charJe/power-user/readme.org

#+title: Power User Keyboard
#+author: Charles

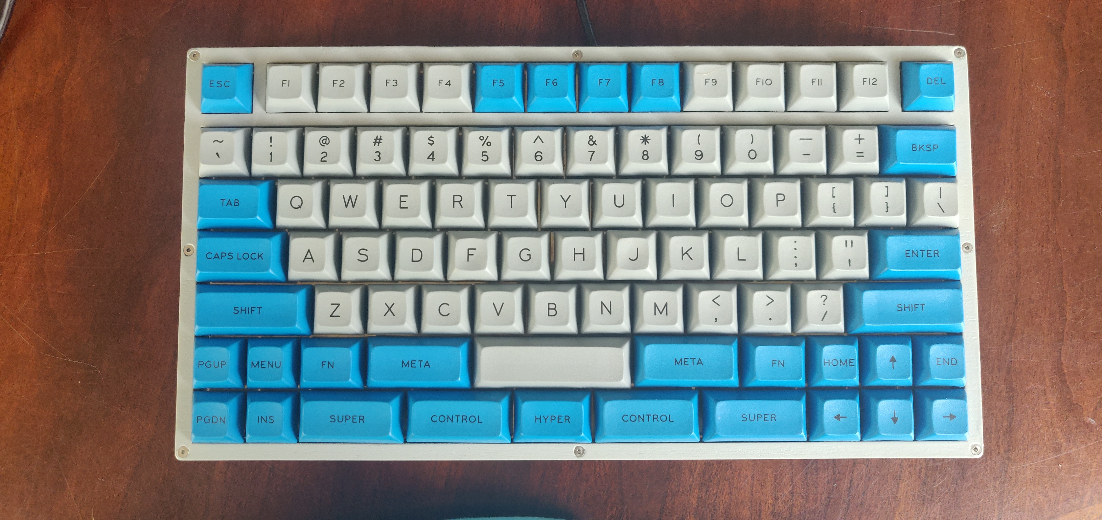
[picture p1: images/done.jpg]


This is a walk through of how I made this keyboard with a non-conventional (extra) bottom row. I hope that it can serve others trying to make custom keyboards.

* Parts and Cost
| Part             | Vendor               | Price ($) | Actual ($) |
|------------------+----------------------+-----------+------------|
| Switches (90)    | [[https://novelkeys.xyz/products/novelkeys-x-kailh-box-heavy-switches?variant=3747939942440][novelkeys.xyz]]        |     27.00 |      30.69 |
| Key caps (alpha) | [[https://pimpmykeyboard.com/dsa-standard-sublimated-keysets/][pimpmykeyboard.com]]   |     50.00 |      50.00 |
| Key caps (mods)  | [[https://pimpmykeyboard.com/dsa-standard-sublimated-keysets/][pimpmykeyboard.com]]   |     40.00 |      40.00 |
| Custom caps      | [[https://pimpmykeyboard.com/dsa-individual-keys/][pimpmykeyboard.com]]   |     42.00 |      42.00 |
| Space bar        | [[https://pimpmykeyboard.com/dsa-3-space/][pimpmykeyboard.com]]   |      5.00 |       5.00 |
| Case             | [[https://www.pololu.com/laserquote][pololu.com]]           |    142.00 |     156.95 |
| bolts            | [[https://www.ebay.com/itm/M2-M2-5-M3-M4-M5-M6-Hex-Socket-Countersunk-Flat-Head-Screws-Bolts-304SS-DIN7991-/173979134769][ebay.com]]             |     10.00 |      10.83 |
| nuts             | [[https://www.ebay.com/itm/Metric-Stainless-Steel-Hex-Nuts-DIN-934-M2-M2-5-M3-M3-5-M4-M5-M6-M8-M10-M12-M14-/112604642017][ebay.com]]             |      3.70 |       4.01 |
| Controller       | [[https://www.pjrc.com/store/teensy.html][pjrc.com]]             |     16.00 |      23.84 |
| Diodes (100)     | [[https://www.ebay.com/itm/100pcs-Brand-New-1N4148-switching-signal-DIODE-ST-DO-35-TZM-afe/113797539967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][ebay.com]]             |      1.35 |       1.93 |
| Stabilizers      | [[https://www.amazon.com/dp/B07K8FFDYJ/ref=psdc_12879431_t2_B07K8G6V1J?th=1][amazon.com]]           |      9.00 |       9.74 |
| USB cable        | [[https://www.amazon.com/gp/product/B000I1IGQ6/ref=ox_sc_act_title_1?smid=A2JSBUBRVPP4SX&psc=1][amazon.com]]           |      3.99 |       4.32 |
| Feet             | Lowes hardware store |      5.69 |       6.47 |
|------------------+----------------------+-----------+------------|
| Total            | -------------------  |    355.73 |     385.78 |
#+tblfm: @15$3=vsum(@2$3..@-1$3)::@15$4=vsum(@2$4..@-1$4)
So about $400 if you include tools and maybe paint.

*Switches* are the parts that complete the electrical circuits. They are the biggest dictator of the feel of your keyboard. For the most part, they come in clicky, tactile, or linear. Make sure they are plate mounted.
*Key caps* are the actual buttons that you touch with your fingers. They usually have letters (legends) on them and are pretty colors. Theses come in different [[https://flashquark.com/wp-content/uploads/2019/08/MDA-Profile-Comparison.jpg][profiles]].
*Case* is the skeleton of your keyboard. In this case it is like a sandwich: many layers that are screwed together. The *plate* is what the switches will fit into.
*Bolts* are finely threaded screws that will hold the case together.
*Nuts* are small hexagonal screw holes that the bolts will screw into to hold the keyboard together. 
*Controller* or micro-controller is a small computer that will take inputs from the switches and send the appropriate signal to your actual computer.
*Diode* is like a [[https://minecraft.gamepedia.com/Redstone_Repeater][redstone repeater]] in that it doesn't let electricity flow "backwards". It will make sure you're keyboard works the way you expect it by stopping the "ghosting" and "masking" problems.
*Stabilizers* keep the long keys on your keyboard from being unstable. Make sure they are plate mounted.
*USB cable* is a usb-b to usb-a wire to connect your micro-controller to your computer.

* Layout
Go crazy on [[http://www.keyboard-layout-editor.com][keyboard-layout-editor.com]], but keep in mind that colors and legends will be limited mainly by what key caps you can find. Know that you may have to adjust your design or pay extra when it comes to key caps. You can use color swatches (at the top of page) to get an idea of what colors are available from different companies.
Here was my final design:
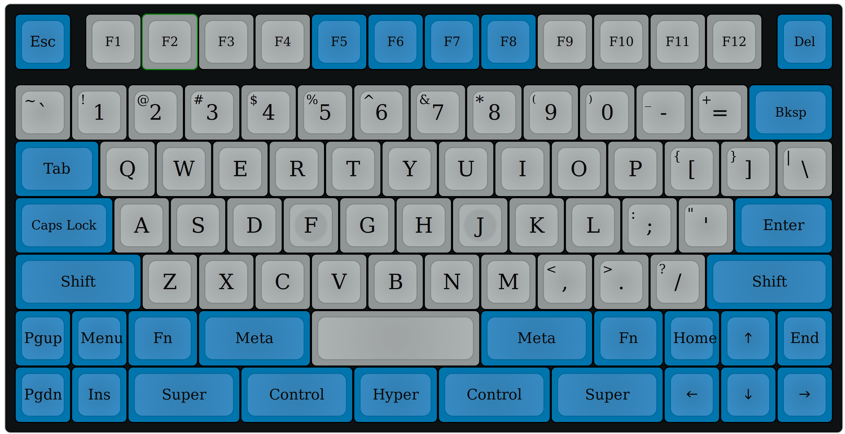
[picture p2: images/layout.png]

* Key caps
I decided Signature Plastics because they have the highest quality custom caps. 

I chose DSA profile because my keyboard has 7 rows, and the 7th row is unavailable on other profiles. DSA is also aesthetically pleasing. It is easier to change keyboard layouts with a non-sculpted profile such as DSA.

For the material, please use something better than ABS plastic; you want your keyboard to be nice for a very long times; the ones I'm getting are PBT plastic. Along the same lines get Dye-sublimated or Double-shot legends so your legends don't rub away (I've heard mixed opinions about laser engraved, and I don't really know).

First, the space bar. They have a 3 unit one in limited colors; I got grey (GDE). The alpha keys need to match the space bar, so I got TKL English Alpha kit (58 grey (GDE) keys). The modifiers can be whatever color; I got TLK text modifiers (33 blue (BCT) keys). I still need some custom ones to complete my abnormal bottom row and right column: 
- 1 unit:
  - "|\"
  - "Menu"
- 1.25 unit: 
  - "Fn" \times 2
- 1.5 unit:
  - "Hyper"
  - "Backspace"
- 1.75 unit:
  - "Enter"
- 2 unit:
  - "Meta" \times 2
  - "Super" \times 2
  - "Control" \times 2
- 2.25 unit:
  - "Shift"
These 14 keys will be blue (BCT) except "|\" which will be grey (GDE).
Here they are laid out on the table:
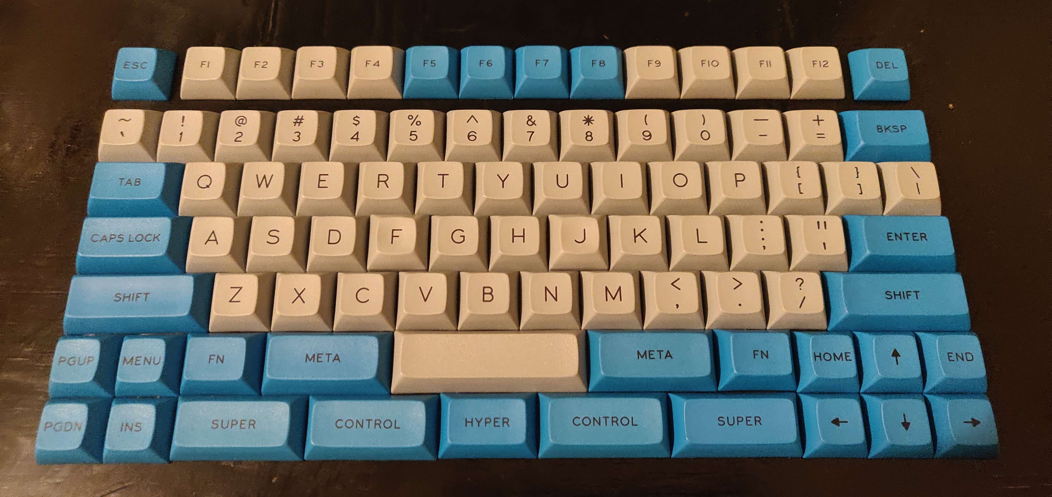
[picture p3: images/key-caps.jpg]


* Case
Copy the [[https://json.org][json.org]] data from the "</> Raw Data" section of [[http://www.keyboard-layout-editor.com][keyboard-layout-editor.com]] into [[http://www.builder.swillkb.com][builder.swillkb.com]] and use the following settings as a guide.
** SVG
If it's not here it is turned off.
| Switch        | MX              |
| Stabilizer    | Cherry + Costar |
| Case          | Sandwich        |
| USB cutout    | -10, 6          |
| Mount holes   | 8, 2.1, 6       |
| Edge padding  | 6, 6, 6, 6      |
| Plate corners | 2               | 
| Kerf          | .008            | 
| Line color    | blue            |

Kerf is important. .008 is for Pololu. If you're using a different laser cutting facility, make sure that you use whatever kerf they specify.

After inputting all the information, have them make the SVG files and download them.

** Laser cutting
| top, open      | 1/4in wood                    |
| bottom         | 0.03in stainless steel        |
| plate          | 0.06in stainless steel        |
| closed \times 2     | 1/8in wood                    |
|----------------+-------------------------------|
| Total -------- | 13/16in (20.5mm, 12.7 inside) |

I used Pololu for this part. Just upload the designs and select whatever materials you want. The plate should be a ridged material, and *the thickness should match your switches and stabilizers*. Make sure you have enough space inside the case to fit the micro controller about (mine just barely fit with .5in (12.7mm)). Space inside would be /open/ + /closed/ \times 2. I chose to use wood so I could countersink, sand, and paint it.

Before painting and countersinking
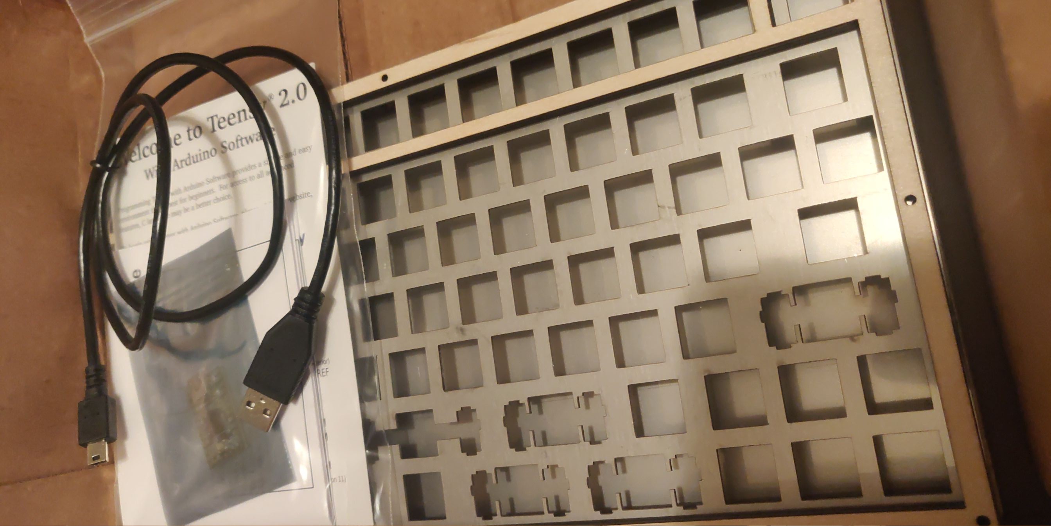
[picture p4: images/plate-teensy.jpg]


After painting and countersinking
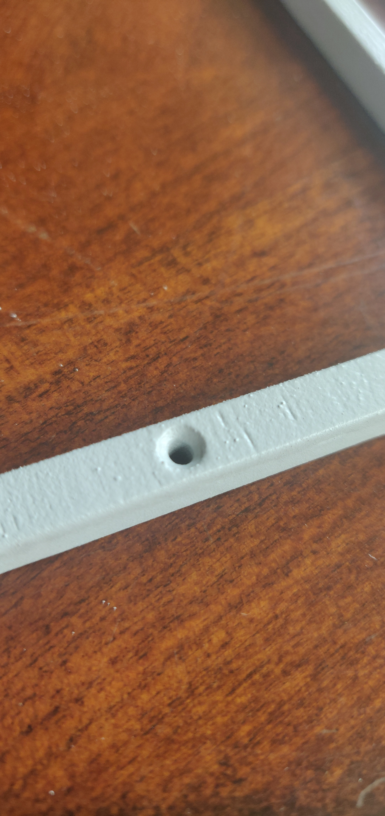
[picture p5: images/done-countersink-paint.jpg]

* Switches
I like clicky switches. With some research, I decided on Kailh pale blue BOX switches. I found a set of 90, so I'll have 3 extras. Since we are not using a PCB, make sure the switches are /plate mounted/, the stabilizers should also be /plate mounted/.
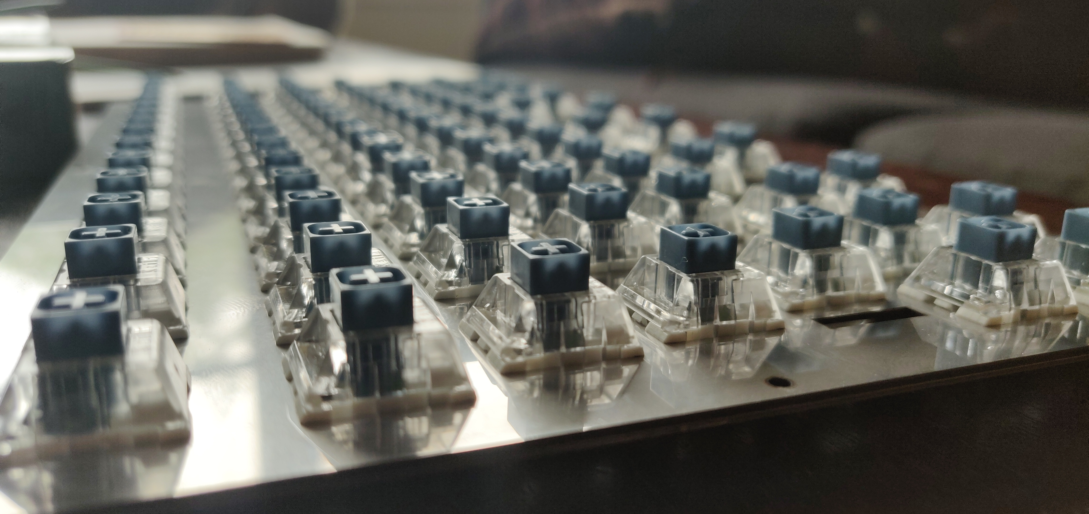
[picture p6: images/switches.jpg]

* Firmware
You should do this before assembly to make sure that everything fits together before soldering. Since I will be using Teensy 2, I'll need the following:
- Install [[https://www.arduino.cc/en/Main/Software][Arduino]] from their website, not your operating system package manage; the Teensy software only works with the version from their website.
- Download and follow instructions for installing [[https://www.pjrc.com/teensy/td_download.html][Teensyduino]].

Documentation:
Get key presses from switches: [[https://www.pjrc.com/teensy/td_digital.html][input documentation]]
Send key presses to computer: [[https://www.pjrc.com/teensy/td_keyboard.html][output documentation]]

For your firmware you should have a plan on how your rows and columns will connect to your micro-controller. This was my plan:

How to connect rows and columns to micro-controller
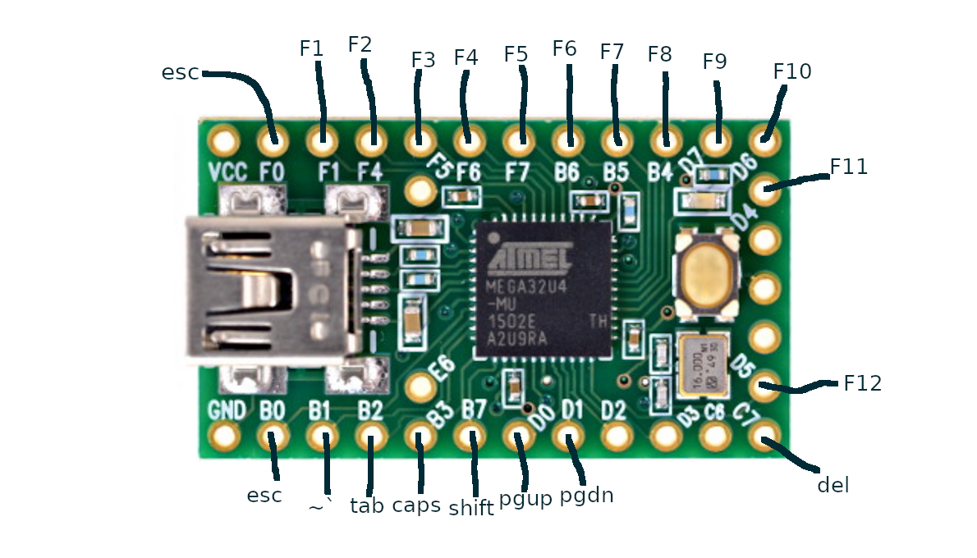
[picture p7: images/schema.png]


Which keys are on which row and column
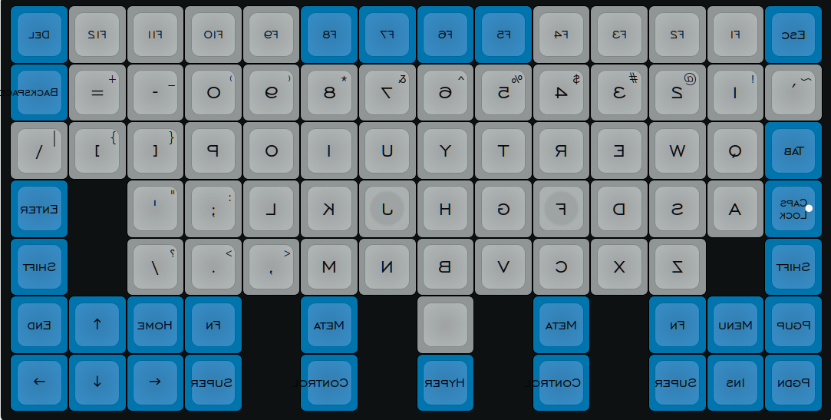
[picture p8: images/matrix.png]

This is reversed because when you are actually soldering, you're looking at the back of the keyboard.
* Assembly
Putting together the case, switches, and key caps should be obvious. The hard part is the wiring. You can look up how to solder by yourself. Remember: 
  - That the wires should be touching before you apply solder.
  - Solder flows to the hottest point, so don't remove the soldering iron until you see the solder flowing to the wires.
  - It's not the end of the world if you mess up; you have extra parts right?
  - The black stripe on the diode should point away from the switch contact it is soldered to.
Here is how the matrix works so you can be more confident.
http://pcbheaven.com/wikipages/How_Key_Matrices_Works/
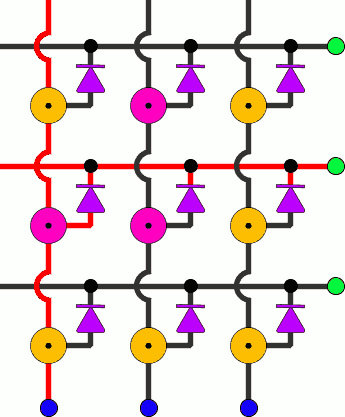
[picture p9: images/sample-matrix.gif]


This part of the guide will be mainly image and example based.
I would suggest preparing all the wires first before soldering. It's not what I did, but I think it would be better.

** Rows
Before doing anything
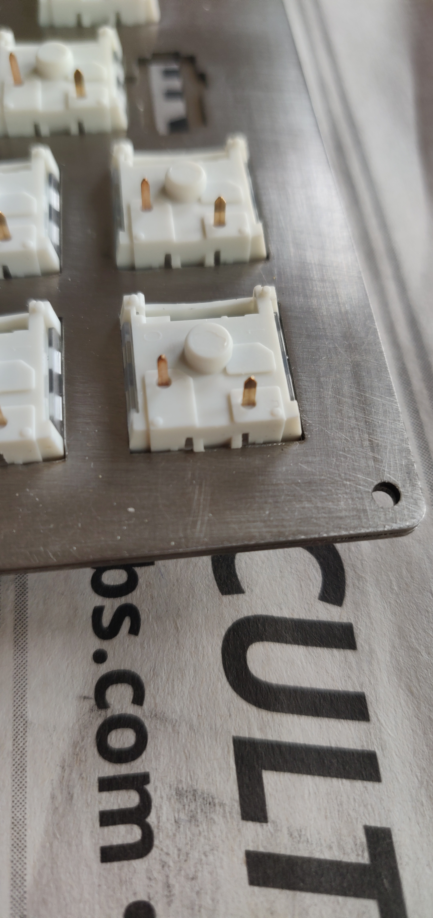
[picture p10: images/before-solder.jpg]


Diode setup
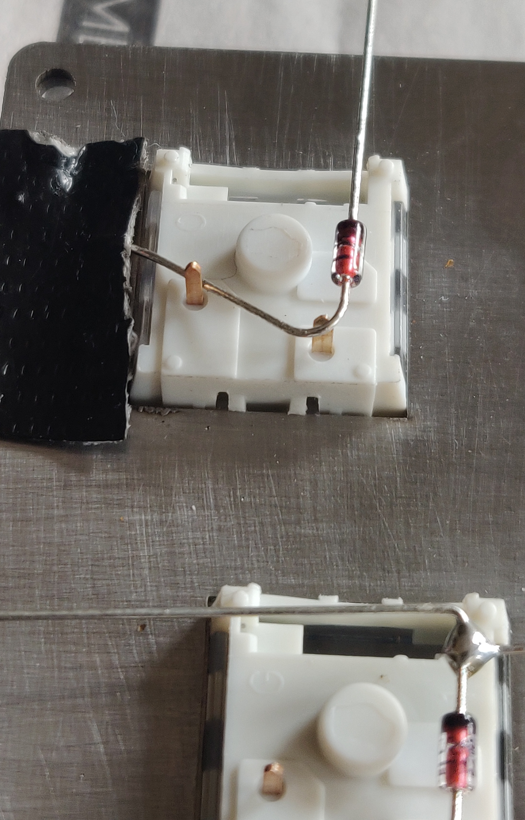
[picture p11: images/diode-setup.jpg]


Diode after first solder
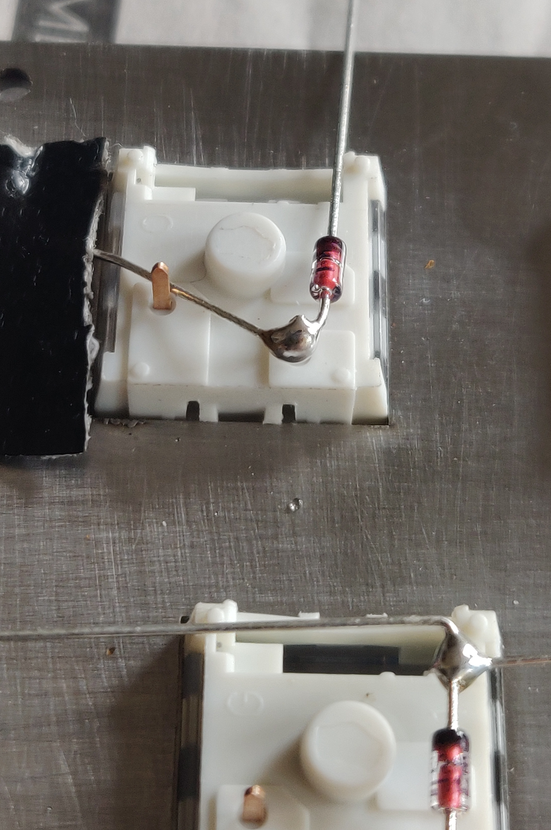
[picture p12: images/diode-after-solder-one.jpg]


Diode after first cut
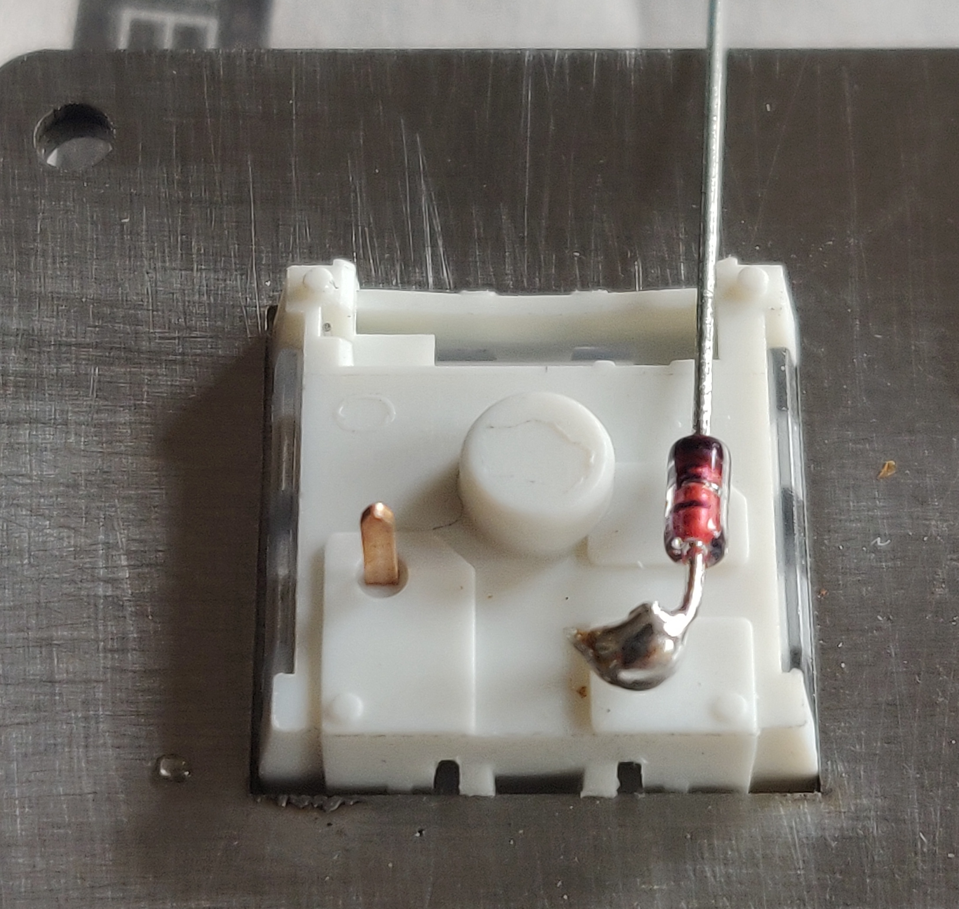
[picture p13: images/diode-after-cut.jpg]


Diode bend to connect to next switch in row
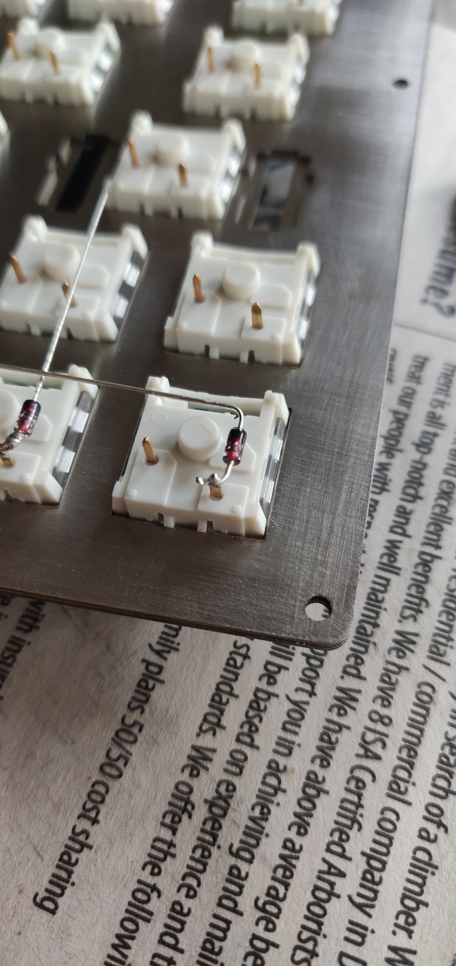
[picture p14: images/diode-after-cut2.jpg]


Done with first row. It looks pretty bad, but it works.
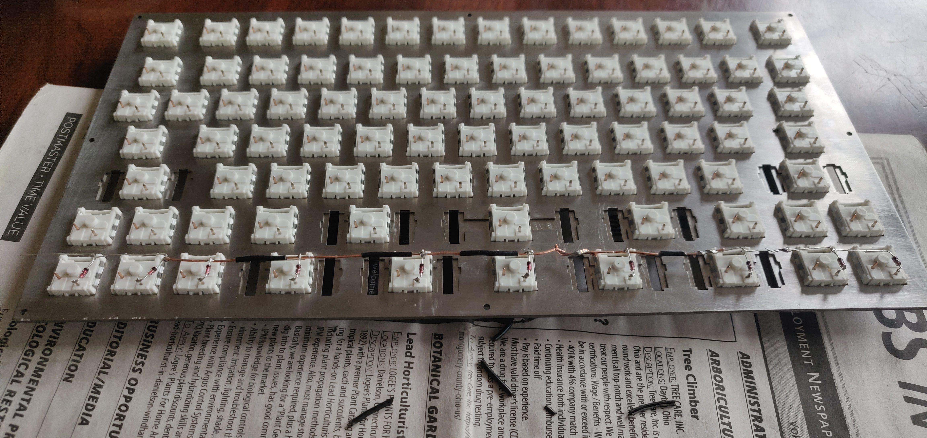
[picture p15: images/done-row-one.jpg]


Other rows look better
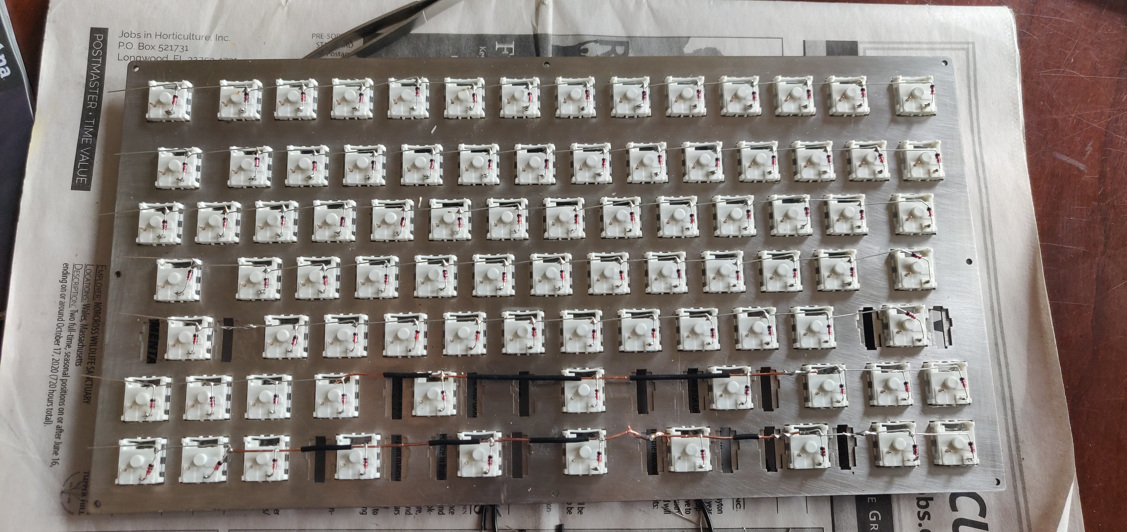
[picture p16: images/done-rows.jpg]


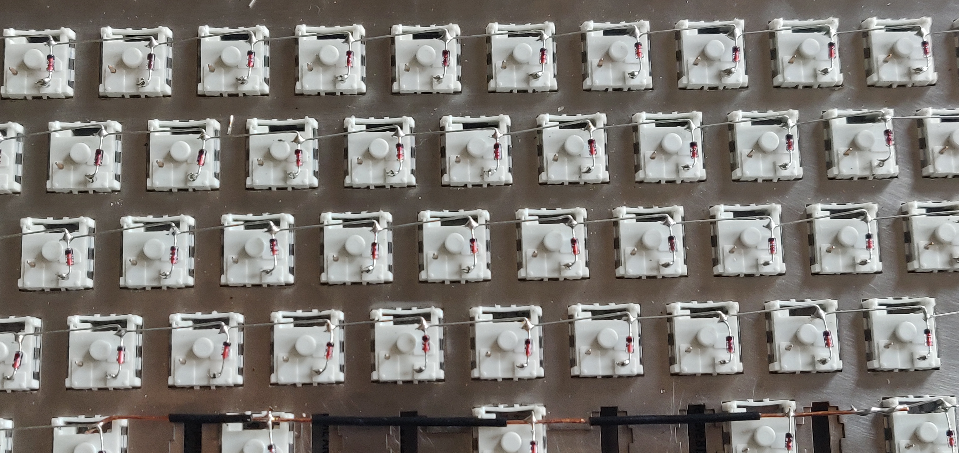
[picture p17: images/done-rows-close.jpg]


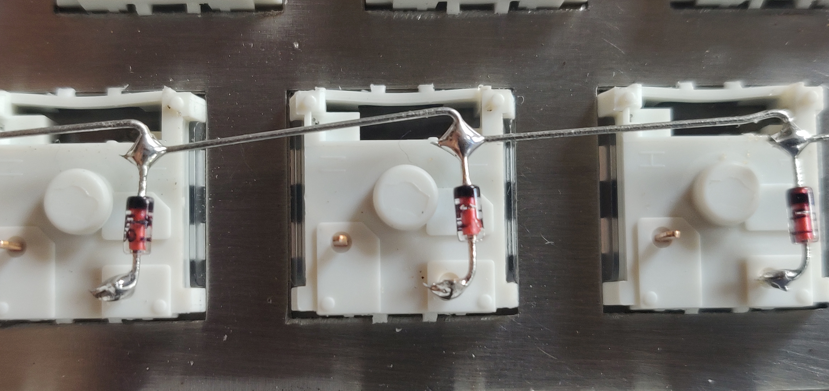
[picture p18: images/done-rows-closer.jpg]


** Columns
It is important to leave as much insulation on the wires as possible so that they do not have contact with the rows.

Setup
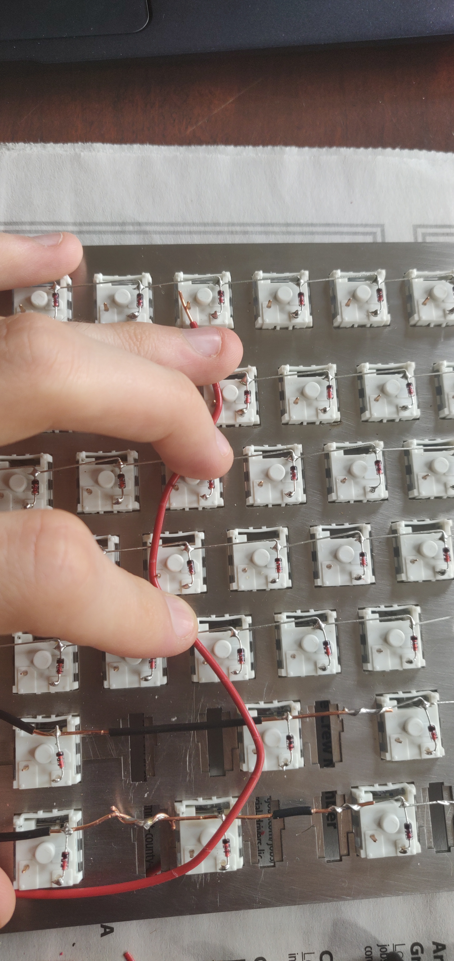
[picture p19: images/column-setup.jpg]


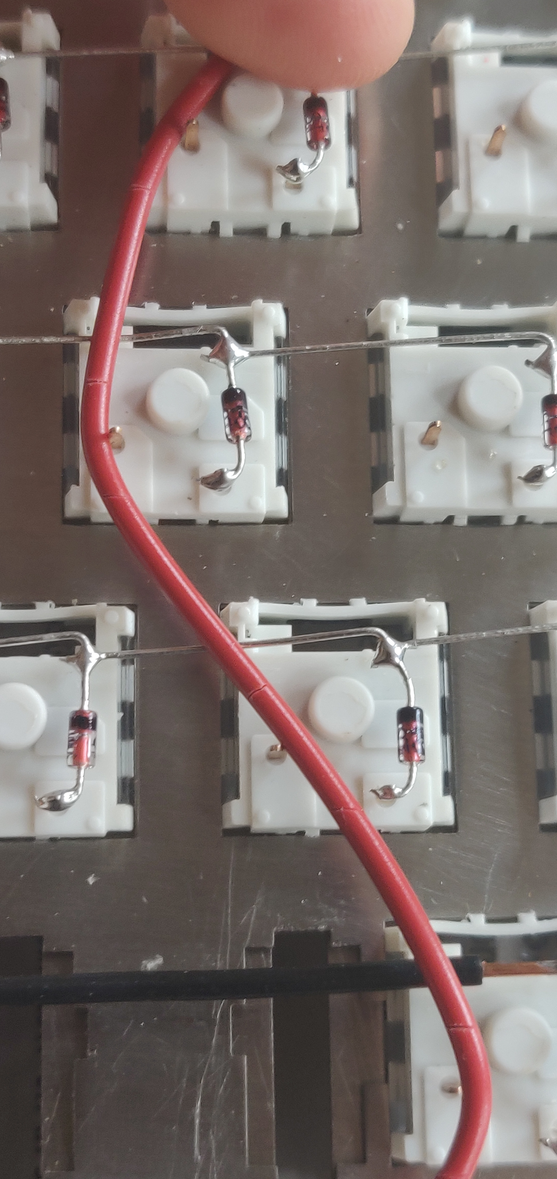
[picture p20: images/column-setup-close.jpg]


Stripped
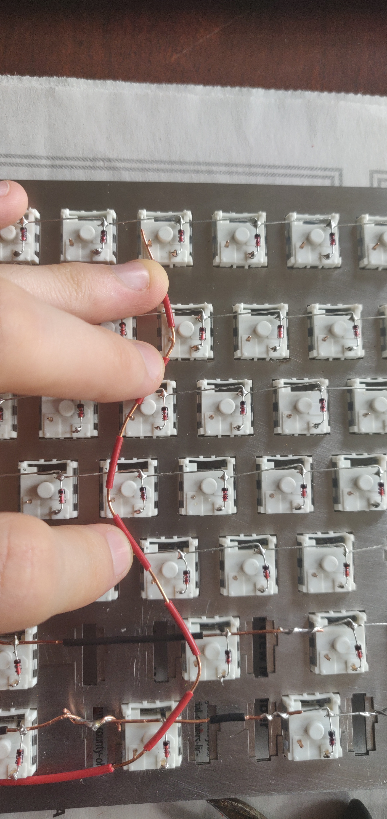
[picture p21: images/column-after-strip.jpg]


Done with first column
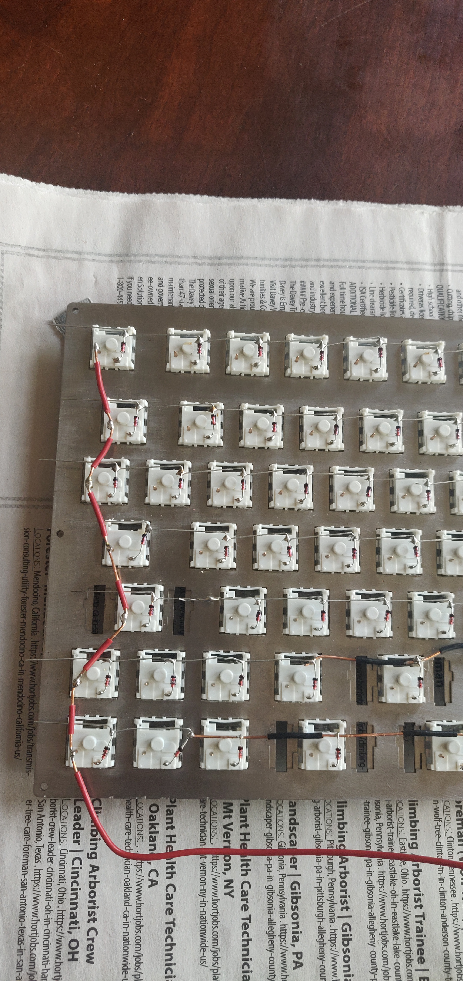
[picture p22: images/done-column-one.jpg]


Finished with wiring
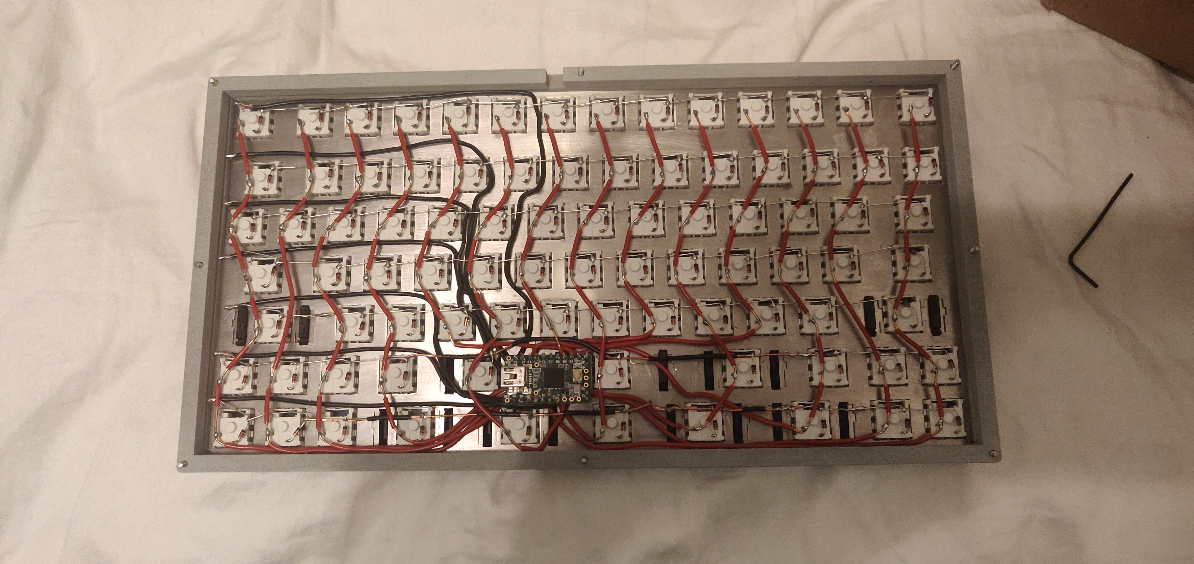
[picture p23: images/done-wires.jpg]


Just make sure you stick with the plan. I had to put some gorilla tape on the plate so that the micro-controller wouldn't cause electrical shortages with the stainless steel.

Now you can put key caps on. You will want stabilizers on any keys that are 2 units or longer. If you have Kailh box switches, then you only need stabilizers on keys that are /longer/ than 2 units.
I had to cut and bend a regular space stabilizer to fit the 3 unit
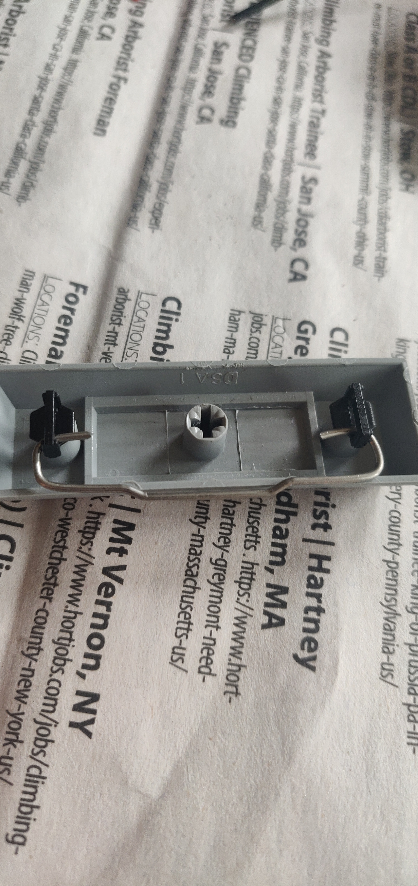
[picture p24: images/stab-space.jpg]


Stabalizer mounts on a shift key
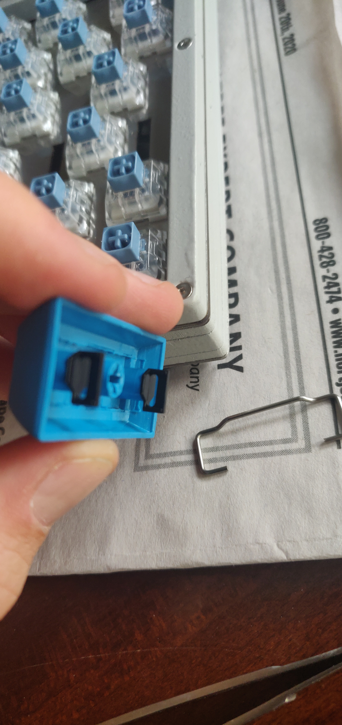
[picture p25: images/stab-shift.jpg]


Finished
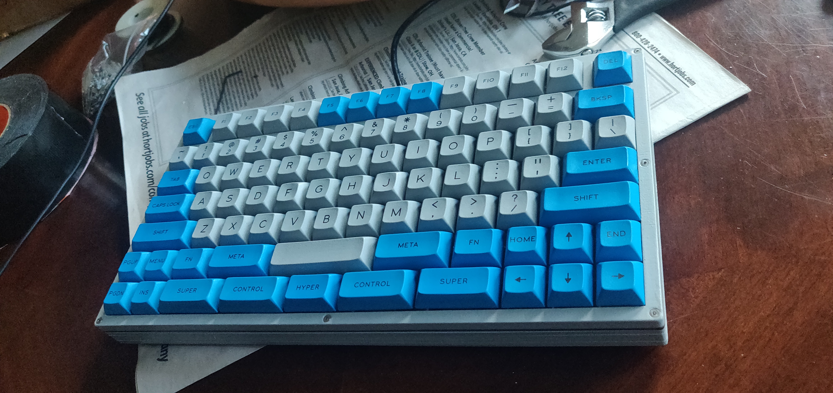
[picture p26: images/done3.jpg]


Slap some washing machine feet on the bottom for maximum stability!
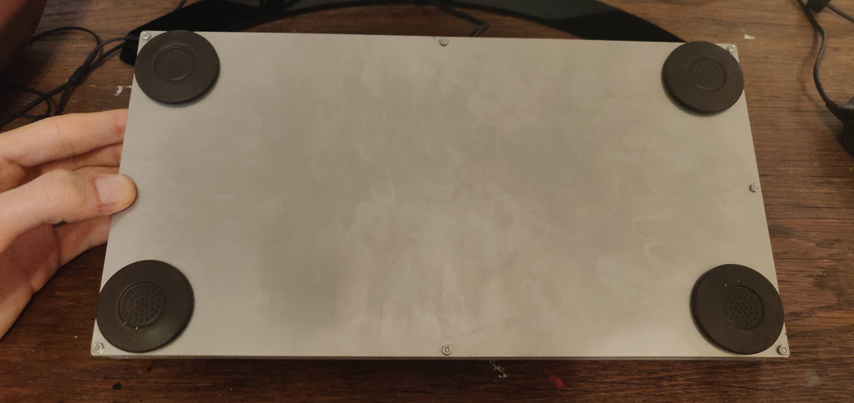
[picture p27: images/feet.jpg]


* Hyper Key
Since Hyper isn't in the USB HID standard, I made the hyper key send right super while both supers keys send left super. Then I tell my computer to interpret right super as hyper. This is my method.

Modify ~/usr/share/X11/xkb/symbols/pc~ like so:
#+BEGIN_SRC c
  // replace
  key <RWIN> {	[ Super_R		]	};
  // with
  key <RWIN> {	[ Hyper_R		]	};

  // replace
  modifier_map Mod4   { <HYPR> };
  // with
  modifier_map Mod3   { <HYPR> };
#+END_SRC

Then reboot computer and it should be working.
