charJe/power-user/images/before-countersink.jpg

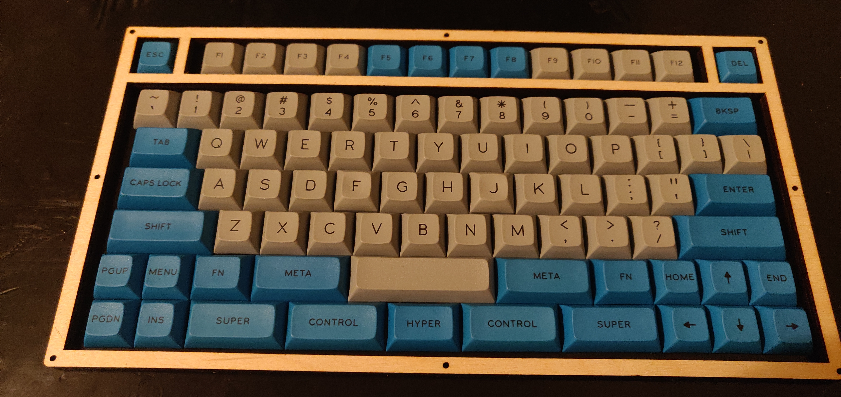
images/before-countersink.jpg
