charJe/power-user/images/column-after-strip-close.jpg

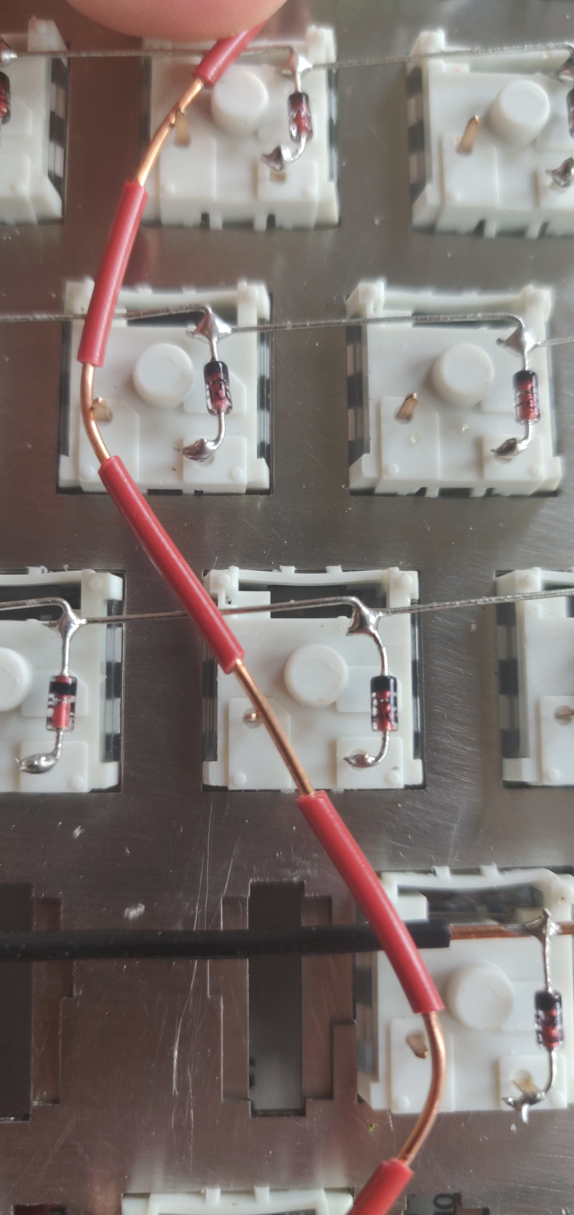
images/column-after-strip-close.jpg
