charJe/power-user/images/done2.jpg

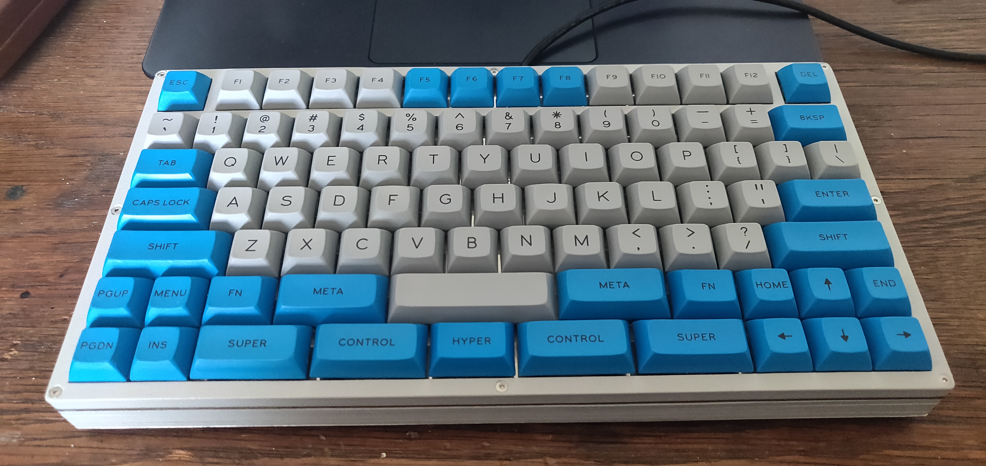
images/done2.jpg
