charJe/power-user/images/diode-before-solder.jpg

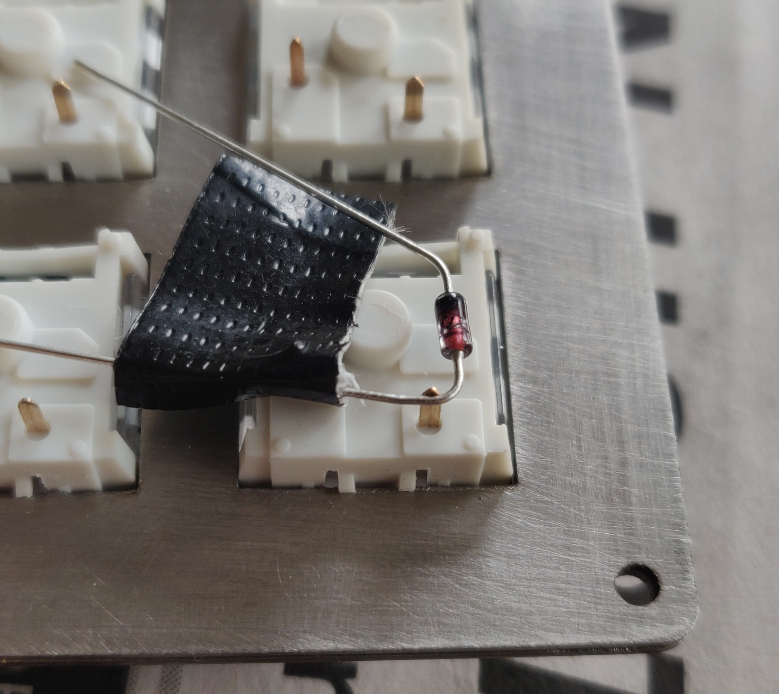
images/diode-before-solder.jpg
