charJe/power-user/images/good-solder.jpg

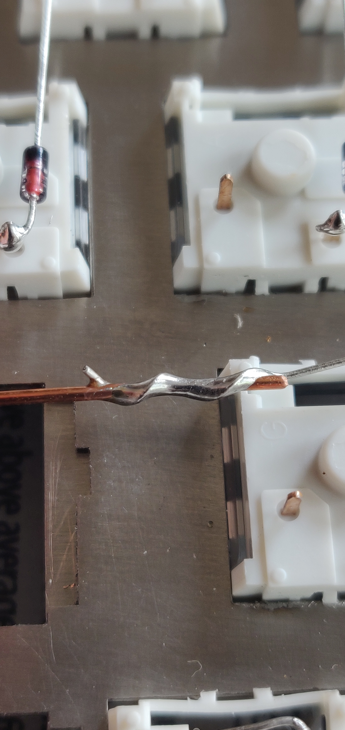
images/good-solder.jpg
